alessiosalvatore1703-ops/Linear-Actuator/arduino/sketch_apr4a/sensore_e_arduino/sensore_e_arduinoModulo_2/sensore_e_arduinoModulo_2.ino

#include <Arduino.h>
int IN11 = 22;
int IN12 = 23;
int IN13 = 24;
int IN14 = 25;
int IN21 = 26;
int IN22 = 27;
int IN23 = 28;
int IN24 = 29;
int IN31 = 30;
int IN32 = 31;
int IN33 = 32;
int IN34 = 33;
int IN41 = 34;
int IN42 = 35;
int IN43 = 36;
int IN44 = 37;
int IN51 = 38;
int IN52 = 39;
int IN53 = 40;
int IN54 = 41;
int IN61 = 42;
int IN62 = 43;
int IN63 = 44;
int IN64 = 45;
int IN71 = 46;
int IN72 = 47;
int IN73 = 48;
int IN74 = 49;
int IN81 = 50;
int IN82 = 51;
int IN83 = 52;
int IN84 = 53;


struct Solenoide {
    int pin1;
    int pin2;
};

Solenoide matriceSolenoidi[2][8] = {
    // Riga 1 
    {{IN14, IN13}, {IN24, IN23}, {IN34, IN33}, {IN44, IN43}, 
     {IN54, IN53}, {IN64, IN63}, {IN74, IN73}, {IN84, IN83}},
    // Riga 2 
    {{IN11, IN12}, {IN21, IN22}, {IN31, IN32}, {IN41, IN42}, 
     {IN51, IN52}, {IN61, IN62}, {IN71, IN72}, {IN81, IN82}}
};

// Create a union to easily convert float to byte
typedef union{
  float number;
  uint8_t bytes[4];
} FLOATUNION_t;

// Create the variable you want to send
FLOATUNION_t myValue;
FLOATUNION_t xUnion;

float prec_foward = -INFINITY;
float prec_backwards = INFINITY;
float counter_foward = 0;
float counter_backwards = 0;
float dist_giri = 0;
float x = 0;
const float pitch_coils = 1;
const int num_magn = 4;
const float diam_coil = 25;
const int num_coils = 8;
const float pitch = diam_coil + pitch_coils;
unsigned long previousMillis = 0;
unsigned long loopCounter = 0;
const unsigned long LOOP_PERIOD = 10;  // Periodo del loop in ms (20Hz)

float mover[2][num_magn] = { 
    {0, 39, 72, 110},              
    {16, 39 + 16, 72 + 16, 110 + 16}            
};

const float coils[num_coils] = {
    pitch * 8, pitch * 9, pitch * 10, pitch * 11,
    pitch * 12, pitch * 13, pitch * 14, pitch * 15
};


/*const float F_ATT_ARRAY[] = {
    0.0, 0.187021081820441, 0.353159506223901, 0.500535346256711, 0.631268674965201, 0.747479565395704, 0.851288090594551, 0.944814323608073, 1.03017833748260, 1.10950020526447,
    1.18490000000000, 1.25849779473553, 1.33241366251740, 1.40876767639193, 1.48967990940545, 1.57727043460430, 1.67365932503480, 1.78096665374329, 1.90131249377610, 2.03681691817956,
    2.18960000000000, 2.36086713923742, 2.54816504370650, 2.74812574817558, 2.95738128741300, 3.17256369618711, 3.39030500926625, 3.60723726141877, 3.81999248741300, 4.02520272201730,
    4.21950000000000, 4.40039274831478, 4.56889496265660, 4.72689703090575, 4.87628934094254, 5.01896228064725, 5.15680623790019, 5.29171160058164, 5.42556875657189, 5.56026809375125,
    5.69770000000000, 5.83920076750348, 5.98389030566712, 6.13033442820141, 6.27709894881684, 6.42274968122387, 6.56585243913300, 6.70497303625469, 6.83867728629944, 6.96553100297771,
    7.08410000000000, 7.19249768167133, 7.28702781467493, 7.36354175628860, 7.41789086379011, 7.44592649445726, 7.44350000556783, 7.40646275439960, 7.33066609823036, 7.21196139433790,
    7.04620000000000, 6.83135000581121, 6.57384643563315, 6.28224104664419, 5.96508559602271, 5.63093184094709, 5.28833153859570, 4.94583644614692, 4.61199832077912, 4.29536891967069,
    4.00450000000000, 3.74649919508381, 3.52269764279245, 3.33298235713462, 3.17724035211902, 3.05535864175437, 2.96722424004937, 2.91272416101273, 2.89174541865315, 2.90417502697934,
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
    0.531180000000000, 0.399663210498647, 0.278242880967077, 0.169666071375061, 0.0766798416923846, 0.00203125188882070, 0.0515326380658482, 0.0812647682018426, 0.0844180785493857, 0.0582455091386984,
    0.0
};

// Funzione di interpolazione lineare per la repulsione
float F_att(float x_mm) {
    // Convert mm to array index (0.1mm steps)
    float x = x_mm * 10.0; // convert mm to 0.1mm units
    if(x <= 0.0 || x >= 229.0) return 0.0; // out of range
    
    int index = (int)x;
    float frac = x - index;
    
    // Linear interpolation
    return F_ATT_ARRAY[index] + (F_ATT_ARRAY[index+1] - F_ATT_ARRAY[index]) * frac;
}

float F_rep(float x_mm) {
    // Convert mm to array index (0.1mm steps)
    float x = x_mm * 10.0; // convert mm to 0.1mm units
    if(x <= 0.0 || x >= 229.0) return 0.0; // out of range
    
    int index = (int)x;
    float frac = x - index;
    
    // Linear interpolation
    return F_REP_ARRAY[index] + (F_REP_ARRAY[index+1] - F_REP_ARRAY[index]) * frac;
}*/



void setup() {
  // initialize serial, use the same boudrate in the Simulink Config block
  Serial.begin(115200);
  for (int i = 0; i < 8; i++) {
        pinMode(matriceSolenoidi[0][i].pin1, OUTPUT);
        pinMode(matriceSolenoidi[0][i].pin2, OUTPUT);
        pinMode(matriceSolenoidi[1][i].pin1, OUTPUT);
        pinMode(matriceSolenoidi[1][i].pin2, OUTPUT);
    }
}
float getFloat(){
    int cont = 0;
    FLOATUNION_t f;
    while (cont < 4 ){
        f.bytes[cont] = Serial.read() ;
        cont = cont + 1;
    }
    return f.number;
  }

// IN TEORIA ELIMINABILE 
/*int calculateCoilMode(float coil_pos, float mover_row[], float x) {
    for (int j = 0; j < num_magn; j++) {
        float dist = coil_pos - (mover_row[j] + x);
        float abs_dist = fabs(dist);
        if (abs_dist < 23) {
            int mode = (dist > 0) ? 1 : ((dist < 0) ? -1 : 0);
            if (mode != 0 && j < num_magn - 1) {
                float dist_next = coil_pos - (mover_row[j + 1] + x);
                float abs_dist_next = fabs(dist_next);
                
                if (abs_dist_next < 23) {
                    // Scegli il magnete più vicino
                    bool next_is_closer = (abs_dist_next < abs_dist);
                    float closest_pos = mover_row[next_is_closer ? j + 1 : j];
                    mode = (coil_pos - closest_pos > 0) ? 1 : -1;
                    return mode;
                }
            }
            return mode;
        }
    }
    return 0;
  }*/


/*ELIMINABILE, SFRUTTA I DATI DELLE CFORZE CHE SONO IMPRECISI
int calculateCoilMode(float coil_pos, float mover_row[], float x) {
  float F_total_rep = 0;
  float F_total_att = 0;
  
  for (int j = 0; j < num_magn; j++) {
    float dist = coil_pos - (mover_row[j] + x);
    float abs_dist = fabs(dist);
    
    if (abs_dist < 23) {  // Soglia di 23 unità
      if (dist < 0) {      // Controllo direzione
        F_total_rep -= F_rep(abs_dist);
        F_total_att -= F_att(abs_dist);
      } else {
        F_total_rep += F_rep(abs_dist);
        F_total_att += F_att(abs_dist);
      }
    }
  }
  
  // Condizione aggiunta per forze nulle
  if (F_total_att != 0 || F_total_rep != 0) {
    if (F_total_att > F_total_rep) {
      return 1;   // Attrazione
    } else {
      return -1;  // Repulsione
    }
  } else {
    return 0;     // Nessuna forza significativa
  }
}*/
//accendo e spengo solenoide in base a dove sta il magnete piu vicino
int calculateCoilMode(float coil_pos, float mover_row[], float x) {
    float min_abs_dist = 100000.0;  // grande valore iniziale
    int closest_index = -1;

    for (int j = 0; j < num_magn; j++) {
        float dist = coil_pos - (mover_row[j] + x);
        float abs_dist = fabs(dist);

        if (abs_dist < 23 && abs_dist < min_abs_dist) { //nota si puo giocare sul valore in zero, che comunque influisce per i prossimi 5 milli
            min_abs_dist = abs_dist;
            closest_index = j;
        }
    }

    if (closest_index != -1) {
        float closest_pos = mover_row[closest_index] + x;
        float dist = coil_pos - closest_pos;
        if (dist > 0) return 1;
        else if (dist < 0) return -1;
        else if (dist == 0) return 0;
    }

    return 0;
} 

void controlSolenoids() {
    for (int m = 0; m < 2; m++) {  // Per ogni riga di solenoidi
        for (int s = 0; s < num_coils; s++) {  // Per ogni solenoide
            int mode = calculateCoilMode(coils[s], mover[m], x);
            // Controllo del solenoide
            digitalWrite(matriceSolenoidi[m][s].pin1, (mode == -1) ? HIGH : LOW); //setta in maniera corretta pin 1 e 2 in base a mode
            digitalWrite(matriceSolenoidi[m][s].pin2, (mode == 1) ? HIGH : LOW);
        }
    }
  }
void loop(){
  unsigned long currentMillis = millis();
  unsigned long elapsed = currentMillis - previousMillis;
// Esegui il codice solo se è passato il periodo desiderato
    if (elapsed >= LOOP_PERIOD) {
        previousMillis = currentMillis;
        loopCounter++;
  myValue.number = getFloat(); // Acquisisci il valore dal sensore
  int alpha = 20919; // per settare in maniera corretta alpha --> quando si accende per la prima volta il sensore leggere che valore returna se posizionato in zero e inserirlo qua
  // === Calcolo posizione continua ===
  float x1 = (myValue.number  - alpha) / 8192.0; 
   /* if (x1 - prec_foward < -7.5) counter_foward++; //logica giri momentaneamente eliminata
    if (prec_backwards - x1 < -7.5) counter_backwards++; //7.5 perche ho un salto di circa 8 giri quando fa overflow
  prec_foward = x1;
  prec_backwards = x1;
  float dist_giri = (counter_foward - counter_backwards) * 48 * PI * 8;*/
  x = x1 * 48 * PI;

for (int m = 0; m < 2; m++) {  // Per ogni riga di solenoidi
  for (int s = 0; s < num_coils; s++) {  // Per ogni solenoide
            int mode = 1;
            // Controllo del solenoide
            digitalWrite(matriceSolenoidi[m][s].pin1, (mode == -1) ? HIGH : LOW); //setta in maniera corretta pin 1 e 2 in base a mode
            digitalWrite(matriceSolenoidi[m][s].pin2, (mode == 1) ? HIGH : LOW);
        }
    }




// Invio del valore x sulla seriale
    xUnion.number = x; // Carichiamo il valore x nell'union
    controlSolenoids();
    //parte eliminabile che rimanda il valore a simulink
    Serial.write('A');                 // Header
    for (int i = 0; i < 4; i++) {      // Payload
      Serial.write(xUnion.bytes[i]);    // Dato o zero
    }
    Serial.print('\n');                // Terminatore
    }
    else {
        delayMicroseconds((LOOP_PERIOD - elapsed) * 1000);
   }
//

}
